j3270/1-Wire-Wing-pcb/README.md

# 1-Wire-Wing-pcb
Feather Wing PCB supporting 1-Wire via a DS2484 I2C to 1-Wire master, or selectable jumper for micros that support 1-Wire natively and bit-banging.
