j3270/1-Wire-Wing-pcb/bom/1-Wire_Wing_BOM.xlsx

 | Engineer | Justin J. Jordan
 | PCB Designer | Justin J. Jordan
 | Project | 1-Wire_Wing
 | Part# | NA
 | Rev | P1
 | PCB Quantity | 5
Item # | Vendor | Manufacturer | Vendor # | Manufacturer # | Description | Designator | Unit Cost | Quantity/PCB | Order Quantity | Cost | Notes:
1 | www.digikey.com | Murata Electronics North America | 490-1524-1-ND | GRM188R71E104KA01D | 0.10µF 25V Ceramic Capacitor X7R 0603 (1608 Metric) 0.063" L x 0.031" W (1.60mm x 0.80mm) | C1 | $0.10 | 1 | 5 | $0.50
2 | www.digikey.com | Murata Electronics North America | 490-1698-1-ND | GRM21BR70J225KA01L | 2.2µF 6.3V Ceramic Capacitor X7R 0805 (2012 Metric) 0.079" L x 0.049" W (2.00mm x 1.25mm) | C2 | $0.16 | 1 | 5 | $0.80
3 | www.digikey.com | Hirose Electric Co Ltd | HFN408CT-ND | FH19C-8S-0.5SH(05) | 8 Position FFC, FPC Connector Contacts, Bottom 0.020" (0.50mm) Surface Mount, Right Angle | CN1 | $1.53 | 1 | 5 | $7.65
4 | www.digikey.com | Murata Electronics North America | 490-2472-1-ND | PRG18BB470MB1RB | PTC Resettable Fuse 24V 29mA Ih Surface Mount 0603 (1608 Metric) | F1 | $0.54 | 1 | 5 | $2.70
5 | www.digikey.com | Sullins Connector Solutions | S1011EC-30-ND | PRPC030SAAN-RC | 30 Positions Header, Unshrouded, Breakaway Connector 0.100" (2.54mm) Through Hole Gold | H1 | $0.63 | 1 | 5 | $3.15
6 | www.digikey.com | Sullins Connector Solutions | S1011EC-30-ND | PRPC030SAAN-RC | 30 Positions Header, Unshrouded, Breakaway Connector 0.100" (2.54mm) Through Hole Gold | H3 | $0.63 | 1 | 5 | $3.15
7 | www.digikey.com | TE Connectivity AMP Connectors | A31422-ND | 5555165-1 | Jack Modular Connector 6p6c (RJ11, RJ12, RJ14, RJ25) 90° Angle (Right) Unshielded Cat3 | J1 | $0.93 | 1 | 5 | $4.65
8 | www.digikey.com | Sullins Connector Solutions | S1011EC-30-ND | PRPC030SAAN-RC | 30 Positions Header, Unshrouded, Breakaway Connector 0.100" (2.54mm) Through Hole Gold | JP1 | $0.63 | 1 | 5 | $3.15
9 | www.digikey.com | Sharp Microelectronics | 425-2900-ND | LS012B7DD01 | Graphic LCD Display Module Transflective White TFT - Monochrome Serial 1.2" (30.48mm) 184 x 38 | LCD1 | $13.98 | 1 | 5 | $69.90
10 | www.digikey.com | Yageo | 311-3.3KGRCT-ND | RC0603JR-073K3L | RES SMD 3.3K OHM 5% 1/10W 0603 | R1, R2, R7 | $0.10 | 3 | 15 | $1.50
11 | www.digikey.com | Yageo | 311-2.2KGRCT-ND | RC0603JR-072K2L | RES SMD 2.2K OHM 5% 1/10W 0603 | R3 | $0.10 | 1 | 5 | $0.50
12 | www.digikey.com | Yageo | 311-1.0KGRCT-ND | RC0603JR-071KL | RES SMD 1K OHM 5% 1/10W 0603 | R4 | $0.10 | 1 | 5 | $0.50
13 | www.digikey.com | Yageo | 311-10KGRCT-ND | RC0603JR-0710KL | RES SMD 10K OHM 5% 1/10W 0603 | R6, R8 | $0.10 | 2 | 10 | $1.00
14 | www.digikey.com | Yageo | 311-33KGRCT-ND | RC0603JR-0733KL | RES SMD 33K OHM 5% 1/10W 0603 | R9 | $0.10 | 1 | 5 | $0.50
15 | www.digikey.com | Sullins Connector Solutions | S9337-ND | QPC02SXGN-RC | 2 (1 x 2) Position Shunt Connector Black Open Top 0.100" (2.54mm) Gold | SHUNT | $0.13 | 1 | 5 | $0.65
16 | www.digikey.com | Omron Electronics Inc-EMC Div | SW1020CT-ND | B3U-1000P | Tactile Switch SPST-NO Top Actuated Surface Mount | SW1-SW5 | $1.18 | 5 | 25 | $29.50
17 | www.digikey.com | Maxim Integrated | DS2484R+U-ND | DS2484R+U | 1-Wire® Controller I²C Interface 6-SOT | U1 | $1.49 | 1 | 5 | $7.45
18 |  |  |  |  |  |  |  |  |  | $137.25
19 |  |  |  |  |  |  |  |  | Cost/PCB | $27.45
20
21
22
23
24
25
26
27
28
29
30
31
32
33
34
35
36
37
38
39
40
41
42
43
44
45
46
47
48
49
50
51
52
53
54
55
56
57
58
59
60
61
62
63
64
65
66
67
68
69
70
71
72
73
74
75
76
77
78
79
80
81
82
83
84
85
86
87
88
89
90
91
92
93
94
95
96
97
98
