j3270/1-Wire-Wing-pcb/KiCad/1-Wire_Wing.pdf

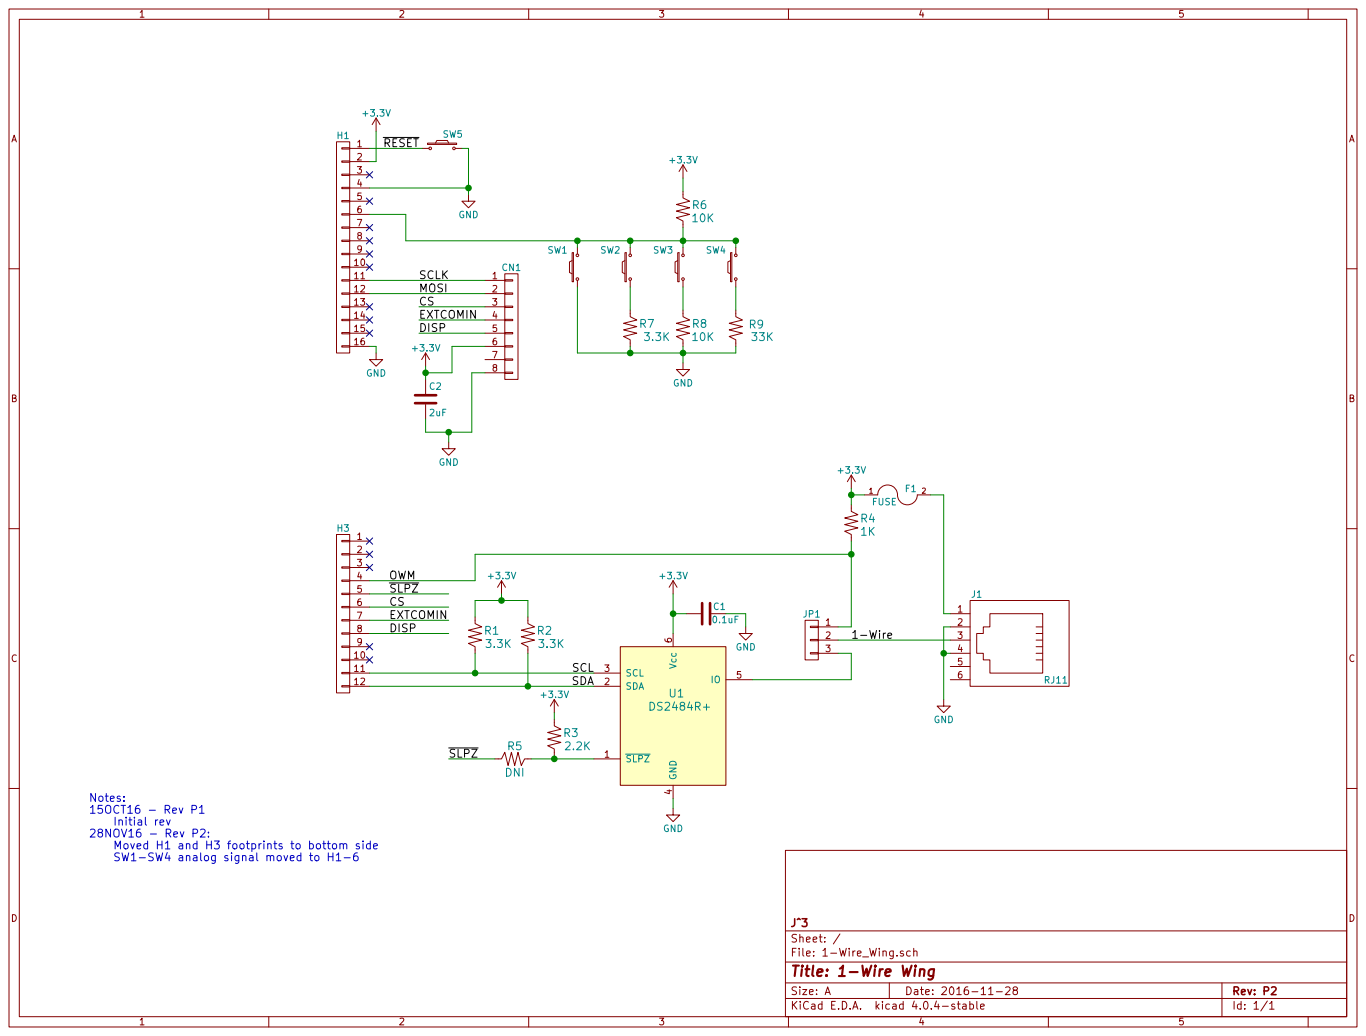
[picture p1: page 1]

12 | 2
13 3

7 | EXTCOMIN
8 DISP

Initial rev 28NOV16 - Rev P2:
Moved H1 and H3 footprints to bottom side
SW1-SW4 analog signal moved to H1-6

Id: 1/1 Title: 1-Wire Wing
