j3270/1-Wire-Wing-pcb/KiCad/1-Wire_Wing.kicad_pcb

## KiCad design KiCad/1-Wire_Wing.kicad_pcb (2017-02-08)

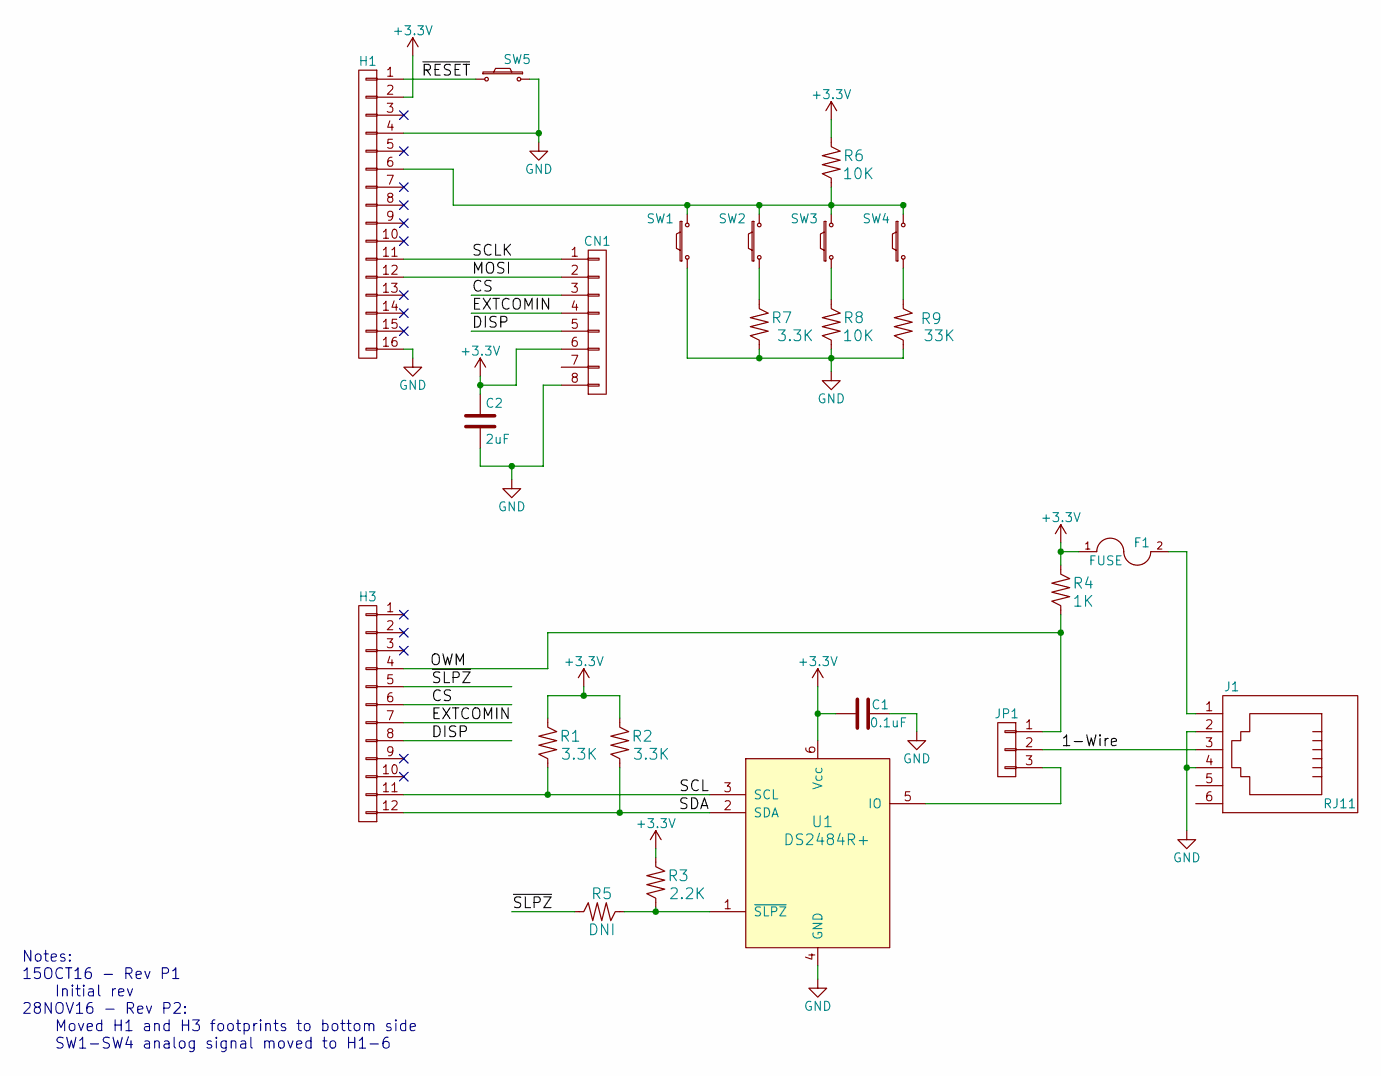
[picture p2: schematic 1-Wire_Wing.sch, 1-Wire Wing]

Parts:
C1: 0.1uF; C_0603_HandSoldering
C2: 2uF; C_0805_HandSoldering
CN1: CONN_01X08; HIROSE_FH19C-8S-0.5SH(05)
F1: FUSE; C_0603_HandSoldering
H1: CONN_01X16; Pin_Header_Straight_1x16
H3: CONN_01X12; Pin_Header_Straight_1x12
J1: RJ11; TE_6P6C_5555165-1
JP1: CONN_01X03; Pin_Header_Straight_1x03
R1, R2, R7: 3.3K; R_0603_HandSoldering
R3: 2.2K; R_0603_HandSoldering
R4: 1K; R_0603_HandSoldering
R5: DNI; R_0603_HandSoldering
R6, R8: 10K; R_0603_HandSoldering
R9: 33K; R_0603_HandSoldering
SW1, SW2, SW3, SW4, SW5: SW_PUSH_SMALL_H; OMRON_B3U-1000P
U1: DS2484R+; SOT95P280X125-6N

Connections:
+3V3: C1.1, C2.1, CN1.6, F1.1, H1.2, R1.1 (A), R2.1 (A), R3.1 (A), R4.1 (A), R6.1 (A), U1.6 (Vcc)
/1-Wire: J1.3, JP1.2
/CS: CN1.3, H3.6
/DISP: CN1.5, H3.8
/EXTCOMIN: CN1.4, H3.7
/MOSI: CN1.2, H1.12
/OWM: H3.4, JP1.1, R4.2 (B)
/SCL: H3.11, R1.2 (B), U1.3 (SCL)
/SCLK: CN1.1, H1.11
/SDA: H3.12, R2.2 (B), U1.2 (SDA)
/~RESET: H1.1, SW5.1
/~SLPZ: H3.5, R5.2 (B)
GND: C1.2, C2.2, CN1.8, H1.4, H1.16, J1.2, J1.4, R7.2 (B), R8.2 (B), R9.2 (B), SW1.1, SW5.2, U1.4 (GND)
unnamed: F1.2, J1.1
unnamed: H1.6, R6.2 (B), SW1.2, SW2.2, SW3.2, SW4.2
unnamed: JP1.3, U1.5 (IO)
unnamed: R3.2 (B), R5.1 (A), U1.1 (~SLPZ)
unnamed: R7.1 (A), SW2.1
unnamed: R8.1 (A), SW3.1
unnamed: R9.1 (A), SW4.1

Notes on the sheet:
Notes: 15OCT16 - Rev P1 Initial rev 28NOV16 - Rev P2: Moved H1 and H3 footprints to bottom side SW1-SW4 analog signal moved to H1-6

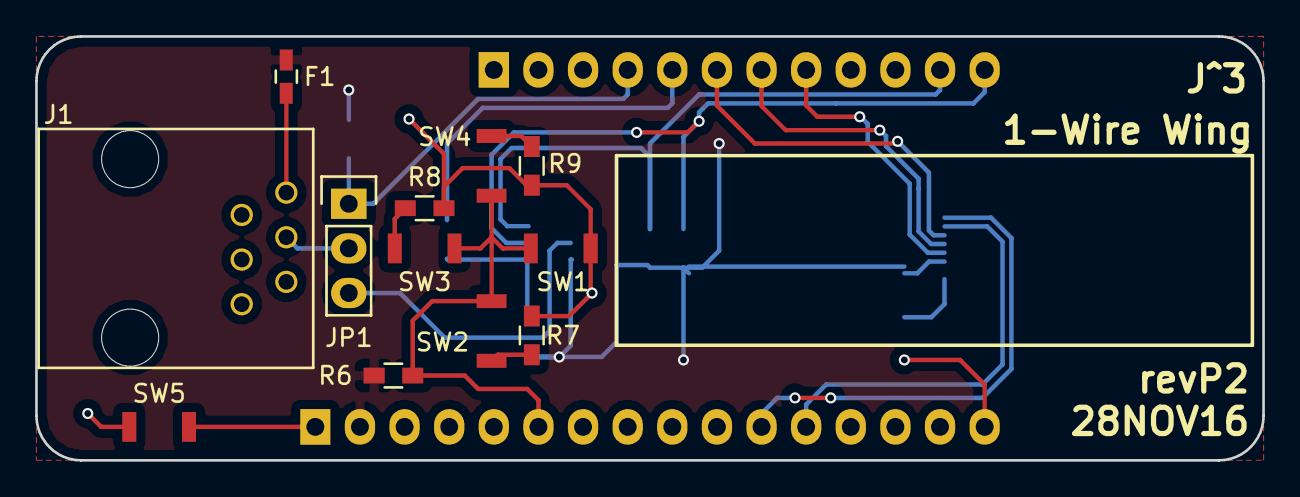
[picture p3: board 1-Wire_Wing.kicad_pcb from above]

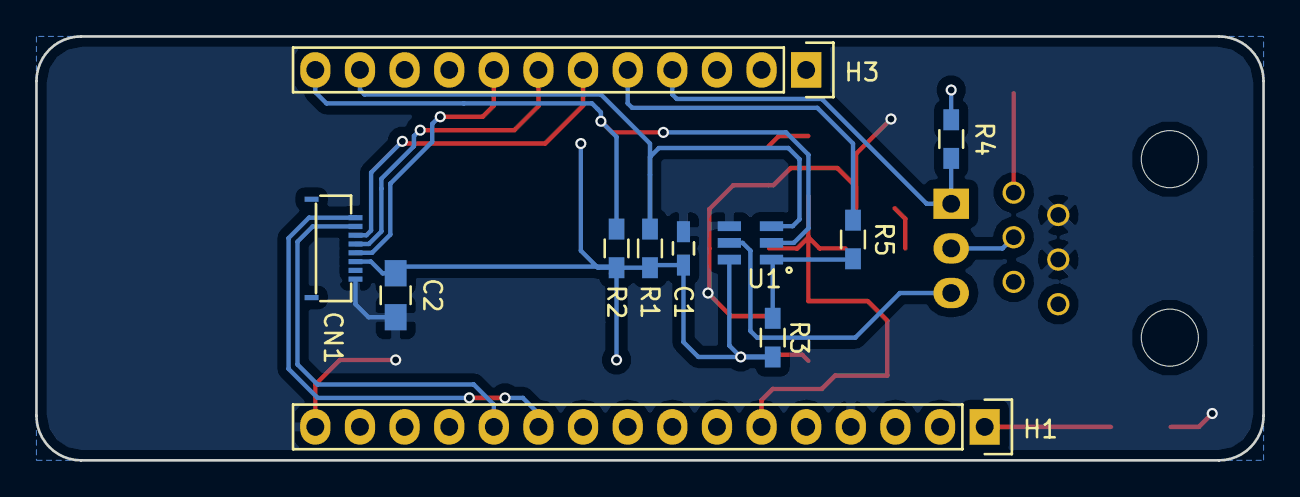
[picture p4: board 1-Wire_Wing.kicad_pcb from below]

Board: 2 copper layers, 69.9 x 24.1 mm, 23 parts (11 on the bottom side), 20 nets.
