j3270/1-Wire-Wing-pcb/(commit log)

2017-02-13 added pdf of schematic
2017-02-13 updated project files
    [1-Wire_Wing.sch]
